Lemus-code/BUCK-CON-PID-CONTROL/README.md

# BUCK-CON-PID-CONTROL
Construí un buck junto a mis compañeros desde 0 en una protobard. Haciendo simulaciones, cálculos y mediciones prácticas,
