Lemus-code/BUCK-CON-PID-CONTROL/LTspice/PID_BUCK.asc

C1: cap; 6.76471µ
C2: cap; 1µ
C3: cap; 1µ
L1: ind; 0.00033113
R1: res; 1
R2: res; 11k
R3: res; 1k
R4: res; 4k
R5: res; 1k
R6: res; 100k
R7: res; 100k
R8: res; 100k
R9: res; 100k
R10: res; 100k
R11: res; 100k
R12: res; 10k
R13: res; 100k
R14: res; 100k
R15: res; 10k
R16: res; 50k
R17: res; 550
R18: res; 10
R19: res; 100k
U1: UniversalOpamp2
U2: UniversalOpamp2
U3: UniversalOpamp2
U4: UniversalOpamp2
U5: UniversalOpamp2
U6: UniversalOpamp2
U7: UniversalOpamp2
U8: UniversalOpamp2
U9: UniversalOpamp2
V1: voltage; 25
V2: voltage; -25
V3: voltage; 3.3
V4: voltage; 1
Named nets: 0, Vcc, Vee, VcCap, E, P, I, D, Dc, out
.tran 0 500m 0 1000u startup
